tomh05/slam-robot/docs/session-handoff.md

# Session Handoff Summary

## Project Status
- Core SLAM robot stack built and committed to GitHub (origin/main: 8a13f2d)
- IMU calibrated (gyro bias, accelerometer offset) and mounted correctly (URDF: imu_x=0.065, imu_y=-0.035, imu_z=0.08)
- Effective track separation calibrated: `track_width_m: 0.238` (over-reporting yaw by 1.53×)
- Wheel odom covariances updated (especially `odom_twist_vyaw_cov: 0.05`)
- `scripts/calibrate_odom_cov.py` created for future covariance tuning (static + motion measurement)
- `bm160_imu_node.py` covariances tuned: `angular_velocity_covariance=0.000006`, `linear_acceleration_covariance=0.005083`

## Files Changed (committed to main)
1. `docs/imu-bm160-session-notes.md` - motion calibration results and residuals
2. `ros2_ws/src/slam_robot_base/config/arduino_base.yaml` - track width and odom covariances
3. `ros2_ws/src/slam_robot_base/slam_robot_base/arduino_base_node.py` - read odom covariances; use them in `/odom` message covariance

## Recent Actions Completed
- Ran `calibrate_odom_cov.py --imu-only` (30 s static, level)
- Ran `calibrate.bag` (26 s teleop, recorded odom + imu messages)
- Regressed 1-second window yaw-change: slope = 0.6525 → odom over-reports by factor 1.53
- Computed effective `track_width_m = 0.238`
- Updated IMU covariances based on static noise
- Updated odom covariances: `odom_twist_vyaw_cov = 0.05` (from 0.30)

## Suggested Skills for Next Sessions

### Emphasize SLAM bringup (Phase 8 from implementation-plan.md)
- **calibrate_ticks_per_rev.py** – bench calibration of ticks per revolution and distance scale (after wheel motion tests)
- **calibrate_odom_cov.py** – static + motion covariance measurement (already added, just need to run for actual motion)
- **setup:** ensure ROS 2 Jazzy is sourced on Pi, run `colcon build --symlink-install`

### Key Next Steps (in order)
1. **Verify config on Pi** – sync, rebuild, launch `robot_core_ekf.launch.py`
2. **Calibrate ticks-per-metre** – run `scripts/calibrate_ticks_per_rev.py` (lift robot, hand-spin wheels)
3. **Run odometry floor test** – drive straight 1 m, compare to tape; rotate 90°, compare yaw
4. **Create SLAM launch files** – `config/slam_toolbox_mapping.yaml` + `launch/slam_mapping.launch.py`
5. **First mapping session** – slow teleop, save map with `nav2_map_server`

### Quick Checklist Before SLAM
- [ ] `slam_robot.urdf.xacro` IMU mount updated (done)
- [ ] `arduino_base_node` with tuned odom cov (done)
- [ ] `ekf.yaml` + `imu_calibration.yaml` (existing, tuned)
- [ ] `slam_robot_bringup/CMakeLists.txt` + `package.xml` – install `slam_toolbox` (need to add exec_depend)
- [ ] `robot_core_ekf.launch.py` – ensure `/odom` vs `/odometry/filtered` covariance reflect tuning
- [ ] Test: `/odom` yaw should now be within ~2° of `/imu/data` integrated yaw (after track width fix)

## Notes for Future Sessions
- The IMU yaw sign is verified (CCW turn → positive angular_velocity.z)
- IMU bias residuals are small (x=-0.015, y=-0.0096, z=-0.0045 rad/s) but should be revisited in bias calibration
- `bm160_imu_node` angular_velocity_covariance is 0.000006 (rad²/s²) – very tight, reflecting good IMU
- The biggest error source right now is track width (scale), not covariance
- For further covariance tuning, `scripts/calibrate_odom_cov.py` can be used with motion recordings

## Next Session Focus
Given the above, the most pressing is to finish odometry calibration (ticks-per-metre, track width) and then implement SLAM bringup. The configuration is now in a good state to proceed with Phase 8.

---
**Author:** Current session agent
**Date:** 2025-11-22
**Repo:** https://github.com/tomh05/slam-robot
