tomh05/slam-robot/lidar-resources/YDLidar-SDK-master/doc/Tutorials.md

# YDLIDAR SDK Tutorials

Non-Beginners: If you're already familiar enough with YDLIDAR SDK, you can go through more in-depth SDK tutorial here. However, going over all basic Beginner Level tutorials is still recommended for all users to get exposed to new features.

If you are new to Linux/windows: You may find it helpful to first do a quick tutorial on common command line tools for linux/windows. A good one is here. 

# Table of Contents
- [Beginner Level](#Beginner-level)
    - [Writing a Simple Lidar Turorial (C++)](#writing-a-simple-lidar-tutorial-(c++))
    - [Writing a Simple Lidar Network Adapter Turorial (C++)](#writing-a-simple-lidar-network-adapter-tutorial-(c++))
    - [Writing a Simple Lidar Turorial (Python)](#writing-a-simple-lidar-tutorial-(python))
    - [Writing a Simple Lidar Turorial (C)](#writing-a-simple-lidar-tutorial-(c))
    - [Examining the simple lidar tutorial](#examining-the-simple-lidar-tutorial)

## Beginner Level
### [Writing a Simple Lidar Tutorial (C++)](tutorials/writing_lidar_tutorial_c++.md)
This tutorial covers how to write a lidar tutorial in C++. 
### [Writing a Simple Lidar Network Adapter Tutorial (C++)](tutorials/writing_lidar_network_adapter_tutorial_c++.md)
This tutorial covers how to write a lidar network adapter tutorial in C++. 
### [Writing a Simple Lidar Tutorial (Python)](tutorials/writing_lidar_tutorial_python.md)
This tutorial covers how to write a lidar tutorial in Python. 
### [Writing a Simple Lidar Tutorial (C)](tutorials/writing_lidar_tutorial_c.md)
This tutorial covers how to write a lidar tutorial in C. 
### [Examining the simple lidar tutorial](tutorials/examine_the_simple_lidar_tutorial.md)
This tutorial examines running the lidar tutorial.
