tomh05/slam-robot/(commit log)

2026-09-07 improve arduino
2026-10-14 laser and lidar
2026-10-21 lidar: fix YDLIDAR sample offset, rewrite node on a verified decoder
    Root cause of the bogus ranges (distances ~256x too large, wrapping, V shaped
    walls, multiple echoes): the sample block was read at header+9 instead of
    header+10. The YDLIDAR header is 10 bytes (AA 55 CT LSN FSA(2) LSA(2) CS(2))
    and a sample is [quality][dist_lo][dist_hi].
    The framing is now *proven* rather than guessed: the vendor checksum
    (YDLIDAR-SDK ydlidar_driver.cpp) validates 1111/1111 packets of the saved
    capture for header=10, 3 byte samples, intensity first.
    - new lidar_scan_publisher/ydlidar_protocol.py: ROS free decoder (checksum
    validation, SDK interval/angle maths incl. the wrap special case and the
    sec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
    [decode_packet.py, lidar_debug.py, lidar_profile.py, lidar_replay.py, node.py, ydlidar_protocol.py]
2026-11-04 swap wheels
2026-11-04 Update interactive wheel test and fix right motor direction/position tracking
    [arduino_nano_base_controller.ino, arduino_wheel_test.py]
2026-11-04 Fix Arduino motor direction control
    Correct documented motor and encoder pin mappings, count actual rising edges, and keep PI corrections from reversing a commanded motor direction.
    [arduino_nano_base_controller.ino]
2026-11-04 Restore controller wiring assignments
    Keep the original sketch motor and encoder mapping while retaining rising-edge counting and direction-safe PWM control.
2026-11-04 Align encoder interrupt pin mapping
    Use the configured D3/D2 encoder S1 pins consistently in comments, pin-change ISR, and interrupt mask while retaining the existing motor wiring.
2026-11-04 Align right encoder position sign
    Report the right track position forward-positive while preserving its inverted motor command and feedback direction.
    [arduino_nano_base_controller.ino]
2026-11-04 Smooth Arduino motor commands
    Ramp velocity targets, limit PWM changes per control cycle, and avoid integrating while PWM is saturated.
    [arduino_nano_base_controller.ino]
2026-11-09 Add encoder ticks-per-rev bench calibration script
2026-11-09 Fix ticks-per-rev calibration to use raw encoder edge counts
    [calibrate_ticks_per_rev.py]
2026-11-09 Update encoder ticks_per_rev from bench calibration
2026-11-09 Scale encoder ticks_per_rev from odom distance test
2026-11-09 Refine encoder ticks_per_rev from distance test
2026-11-09 Final encoder distance calibration from odom test
2026-11-10 imu ekr
2026-11-11 battery status
2026-11-12 Calibrate default ROS battery voltage scale
2026-11-12 calibrate imu
2026-11-14 calibrate IMU mount pose and verify yaw sign
    - slam_robot.urdf.xacro: set measured physical IMU mount to
    imu_x=0.065 (6.5cm forward), imu_y=-0.035 (3.5cm right),
    imu_z=0.08 (8cm above ground). REP-103: forward=+X, right=-Y.
    - Record verified yaw sign: slow CCW turn gives angular_velocity.z > 0,
    so imu_yaw=-pi/2 is correct, no flip needed.
    - Update imu-bm160-session-notes.md TODOs to reflect completion.
    [slam_robot.urdf.xacro]
2026-11-14 add calibrate_odom_cov.py to tune odom/imu covariances + update session notes - new script to estimate IMU noise variance (still samples) and odom yaw-rate residuals - update session notes with new t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
    [arduino_base.yaml, arduino_base_node.py, calibrate_odom_cov.py]
2026-11-14 tune IMU covariances from static noise measurement
    scripts/calibrate_odom_cov.py --imu-only run gave:
    gyro z var = 1e-6 rad^2/s^2 (worst gyro axis y = 6e-6)
    accel x var = 5.083e-3 (m/s^2)^2 (worst accel axis x)
    Set bm160_imu_node defaults and config/imu_calibration.yaml accordingly:
    angular_velocity_covariance: 0.000006
    linear_acceleration_covariance: 0.005083
    Update session notes; flag residual gyro means needing bias review.
    [imu_calibration.yaml]
2026-11-14 tune covariance + effective track width from motion calibration
    - config/arduino_base.yaml:
    * track_width_m: 0.155 -> 0.238 (effective skid-steer separation; odom
    over-reports yaw by 1.53x from calibrate.bag motion regression)
    * odom_pose_x/y_cov: 0.05, odom_pose_yaw_cov: 0.20 (placeholders)
    * odom_twist_vx_cov: 0.10 (leave conservative; no gv)
    * odom_twist_vyaw_cov: 0.30 -> 0.05 (yaw tracks IMU well after scale fix)
    - arduino_base_node.py: mirror odom covariance params into node (declare +
    read), use odom_pose_x_cov/yaw_cov in published covariance matrix.
    - docs/imu-bm160-session-notes.md: record motion calibration results.
    [arduino_base.yaml, arduino_base_node.py]
2026-11-14 Fix lidar_scan_publisher to strip ROS 2 launch args before argparse
    The node was crashing when launched via ros2 launch because ROS 2
    injects --ros-args/-r remapping arguments that argparse doesn't
    recognize. Use rclpy.utilities.remove_ros_args() to filter them
    out before parsing, while still passing the original args to
    rclpy.init() so node remapping works.
    [node.py]
